andresarmento/Tinker-Trike/README.md

Tinker-Trike
============

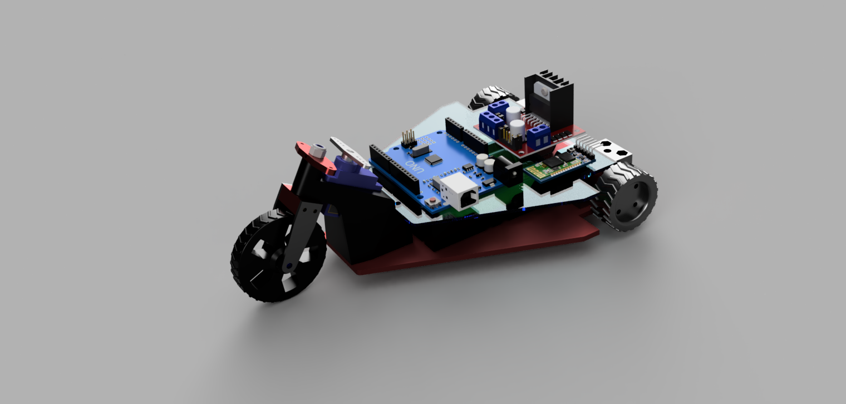
[picture p1: Trike_Complete_2025-Jul-01_01-31.png]
Trike V1.0
