andresarmento/Tinker-Trike/eletronica_trike.png

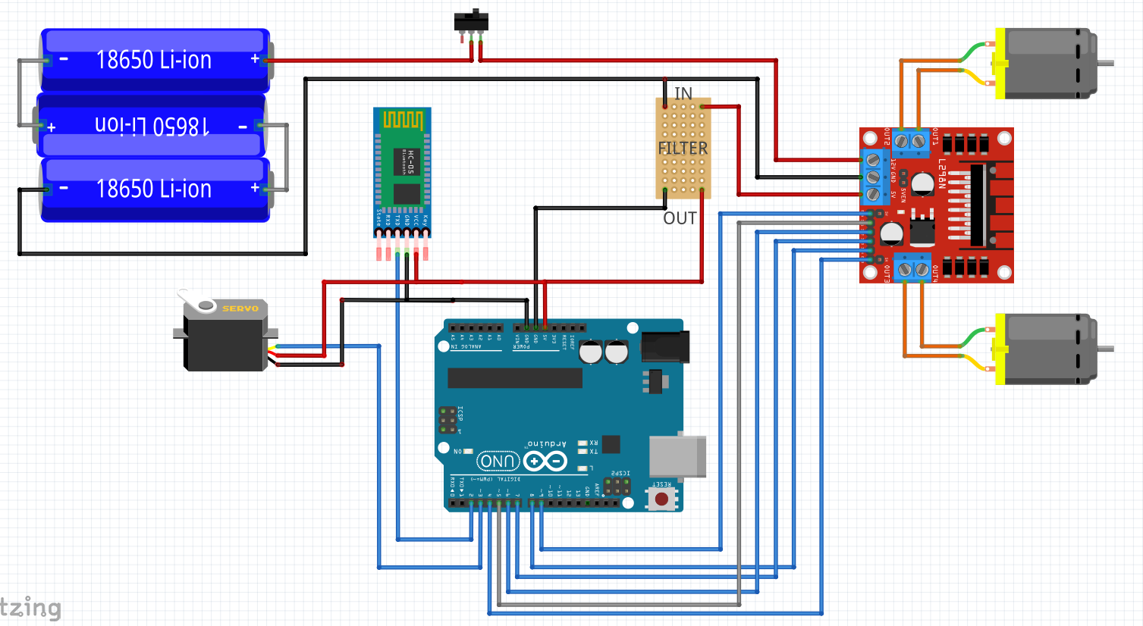
eletronica_trike.png
