andresarmento/Tinker-Trike/Parts models/3D prints/STL/Chassis v47.stl

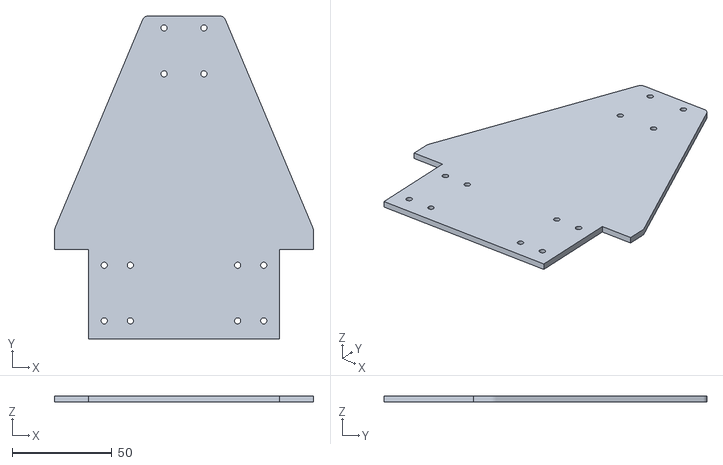
[picture p3: CAD file, 2026-05-27]
Parts models/3D prints/STL/Chassis v47.stl
130.0 x 162.0 x 3.00
