andresarmento/Tinker-Trike/Parts models/3D prints/STL/Top Plate v53.stl

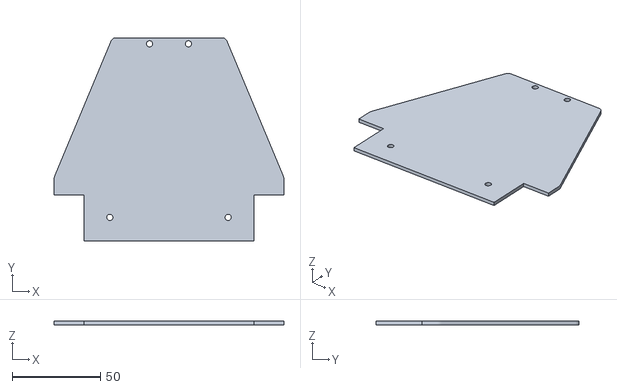
[picture p4: CAD file, 2026-05-27]
Parts models/3D prints/STL/Top Plate v53.stl
130.0 x 115.0 x 2.00
