andresarmento/Tinker-Trike/Parts models/3D prints/STL/Head Tube v43.stl

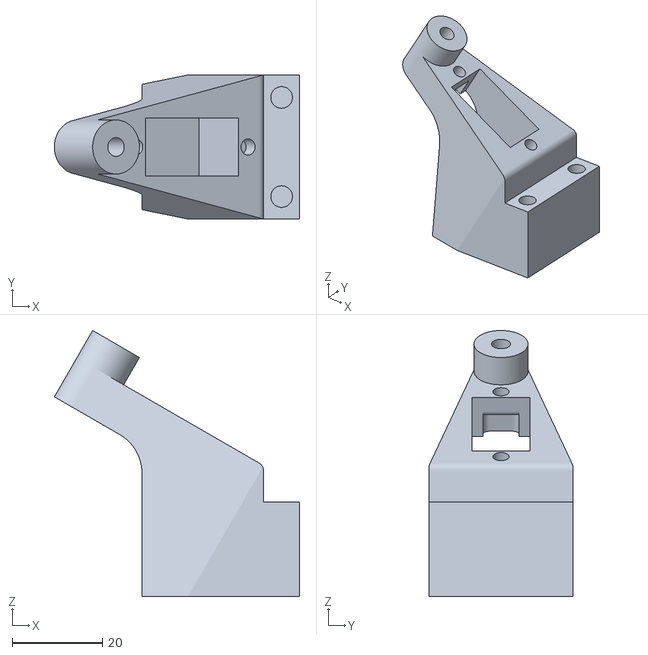
[picture p5: CAD file, 2025-07-05]
Parts models/3D prints/STL/Head Tube v43.stl
54.5 x 32.0 x 59.1
