andresarmento/Tinker-Trike/Parts models/3D prints/STL/Handlebar v12.stl

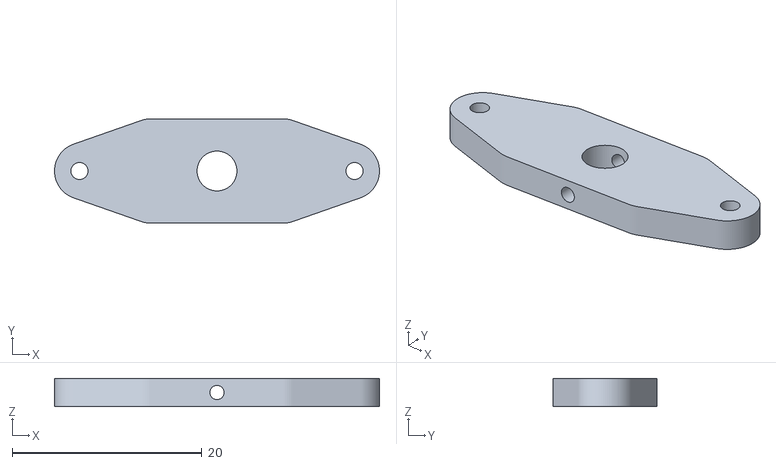
[picture p6: CAD file, 2025-07-05]
Parts models/3D prints/STL/Handlebar v12.stl
34.3 x 11.0 x 3.00
