andresarmento/Tinker-Trike/Parts models/3D prints/STL/Back Wheel No Tire v6.stl

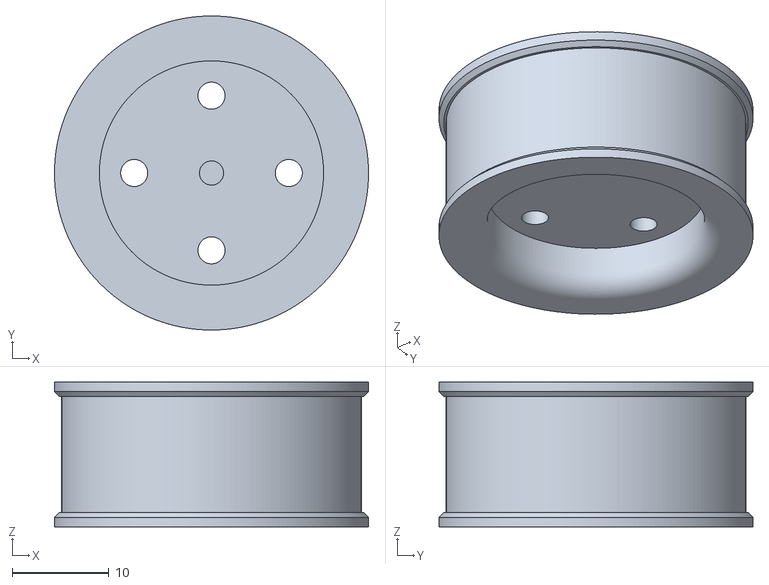
[picture p7: CAD file, 2025-07-05]
Parts models/3D prints/STL/Back Wheel No Tire v6.stl
32.5 x 32.5 x 15.0
