andresarmento/Tinker-Trike/Parts models/3D prints/STL/Servo Link v7.stl

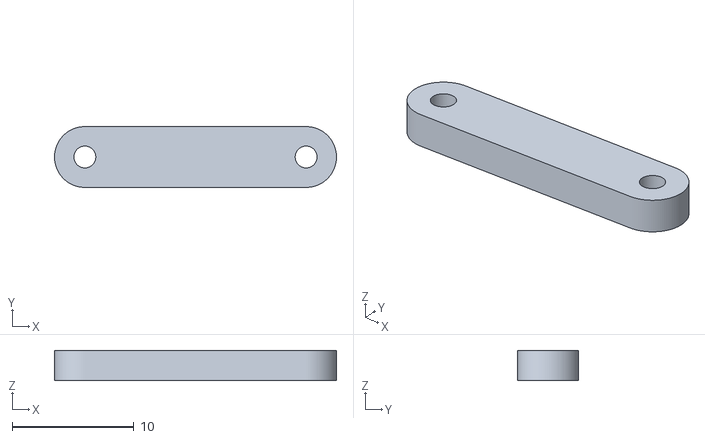
[picture p9: CAD file, 2025-07-05]
Parts models/3D prints/STL/Servo Link v7.stl
23.2 x 5.00 x 2.50
