andresarmento/Tinker-Trike/Parts models/3D prints/STL/Back Wheel v9.stl

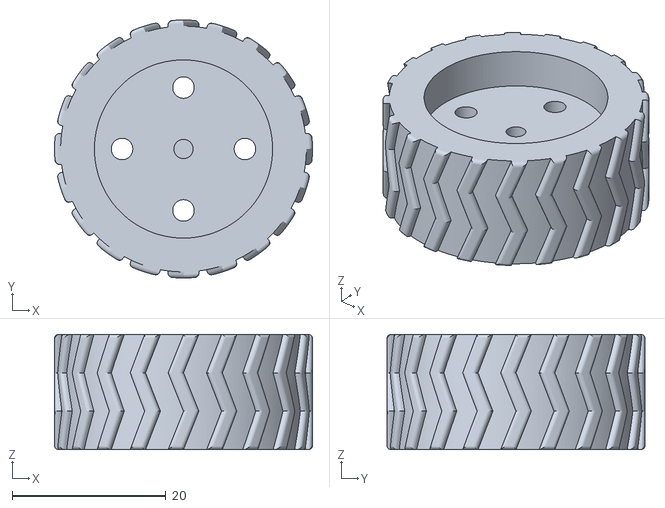
[picture p10: CAD file, 2025-07-05]
Parts models/3D prints/STL/Back Wheel v9.stl
33.6 x 33.6 x 15.0
