andresarmento/Tinker-Trike/Parts models/3D prints/STL/Flange 2.1mm v7.stl

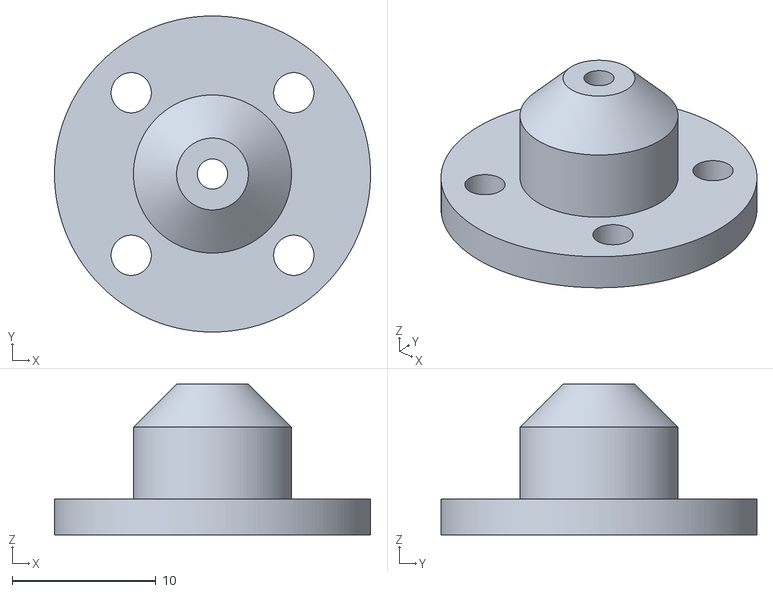
[picture p11: CAD file, 2025-07-05]
Parts models/3D prints/STL/Flange 2.1mm v7.stl
22.0 x 22.0 x 10.5
