andresarmento/Tinker-Trike/Parts models/3D prints/STL/Fork Base v22.stl

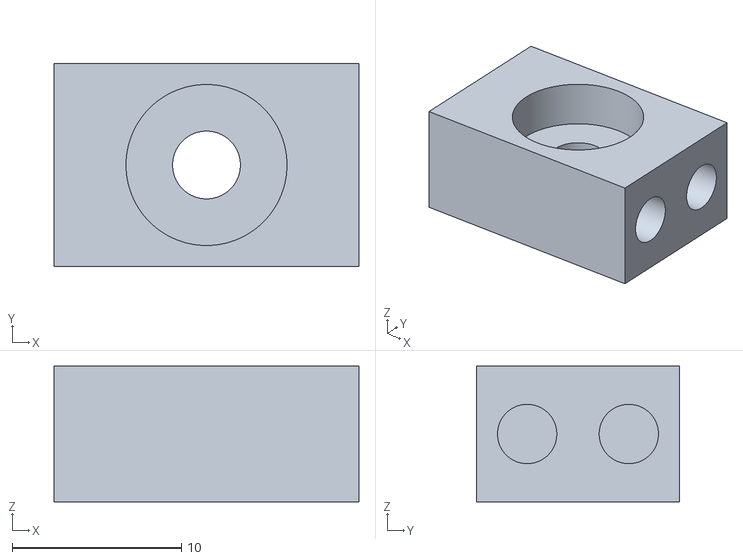
[picture p12: CAD file, 2025-07-05]
Parts models/3D prints/STL/Fork Base v22.stl
18.0 x 12.0 x 8.00
