andresarmento/Tinker-Trike/Parts models/3D prints/STL/Motor Box 180 v13.stl

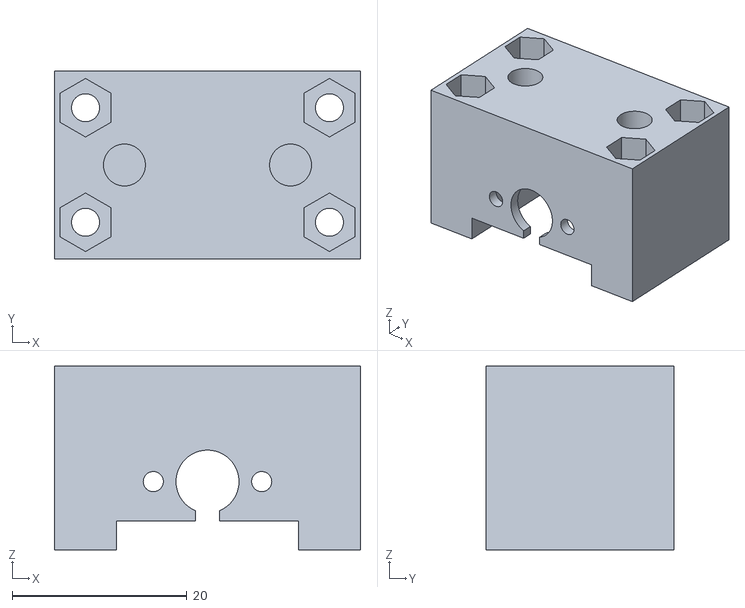
[picture p13: CAD file, 2025-07-05]
Parts models/3D prints/STL/Motor Box 180 v13.stl
35.0 x 21.5 x 21.0
