andresarmento/Tinker-Trike/Parts models/3D prints/STL/Front Wheel No Tire v3.stl

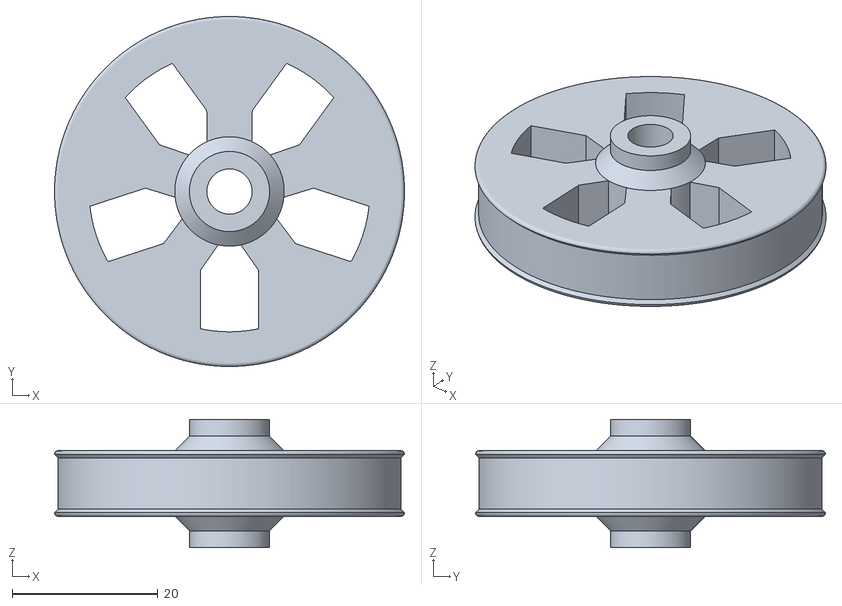
[picture p14: CAD file, 2025-07-01]
Parts models/3D prints/STL/Front Wheel No Tire v3.stl
48.0 x 48.0 x 17.6
