andresarmento/Tinker-Trike/Parts models/3D prints/STL/Front Wheel v20.stl

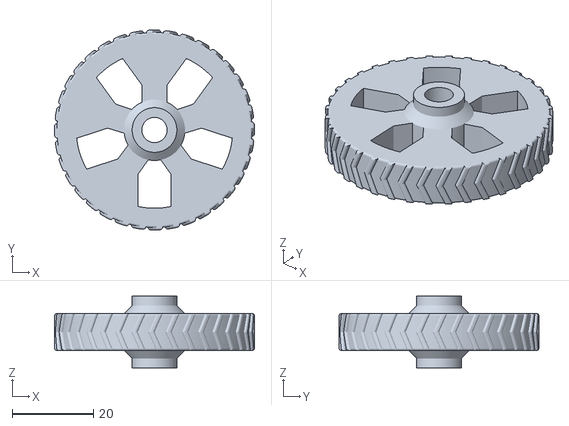
[picture p15: CAD file, 2025-07-01]
Parts models/3D prints/STL/Front Wheel v20.stl
49.2 x 49.2 x 17.6
