andresarmento/Tinker-Trike/Parts models/3D prints/STL/Front Wheel Axle v4.stl

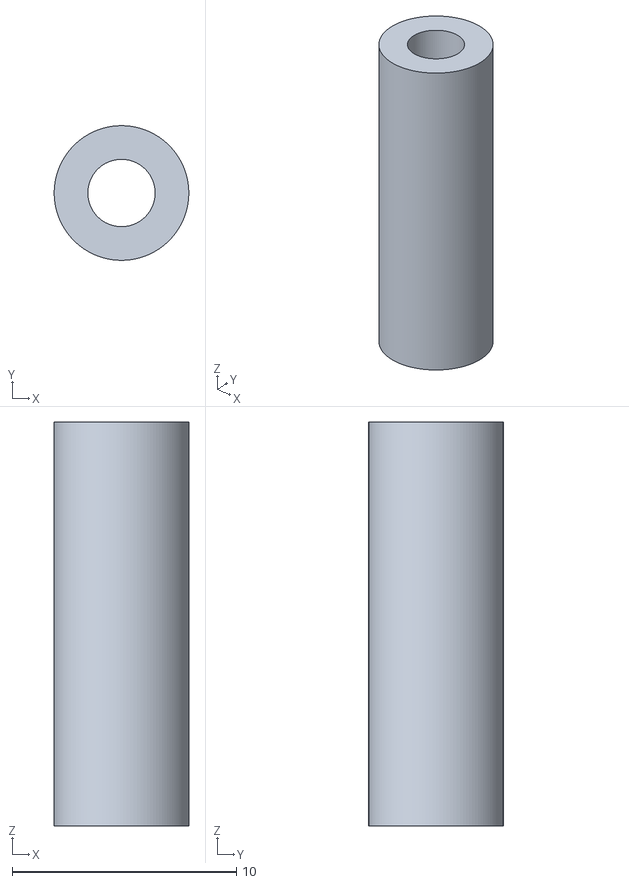
[picture p16: CAD file, 2025-07-01]
Parts models/3D prints/STL/Front Wheel Axle v4.stl
6.00 x 6.00 x 18.0
