andresarmento/Tinker-Trike/(list of files, cad)

Other CAD files:
Parts models/3D prints/STL/Flange 2.2mm v7.stl
Parts models/3D prints/STL/Flange 2.0mm v7.stl
Parts models/3D prints/STL/Flange 2.3mm v7.stl
Parts models/3D prints/Fusion/Back Wheel No Tire v6.f3d
Parts models/3D prints/Fusion/Back Wheel v9.f3d
Parts models/3D prints/Fusion/Flange 2mm v7.f3d
Parts models/3D prints/Fusion/Fork Base v22.f3d
Parts models/3D prints/Fusion/Front Wheel Axle v4.f3d
Parts models/3D prints/Fusion/Front Wheel No Tire v3.f3d
Parts models/3D prints/Fusion/Front Wheel v20.f3d
Parts models/3D prints/Fusion/Handlebar v12.f3d
Parts models/3D prints/Fusion/Head Tube Bearings v3.f3d
Parts models/3D prints/Fusion/Head Tube v43.f3d
Parts models/3D prints/Fusion/Motor Box 180 v13.f3d
Parts models/3D prints/Fusion/Servo Link v7.f3d
Parts models/CNC cuts/Fusion/Chassis v45.f3d
Parts models/CNC cuts/Fusion/Fork End v21.f3d
Parts models/CNC cuts/Fusion/Top Plate v50.f3d
Parts models/Electronics/3x18650 Battery Holder v3.f3d
Parts models/Electronics/Arduino UNO v4.f3d
Parts models/Electronics/H-Bridge_L298N v1.f3d
Parts models/Electronics/HC05_Modulo v2.f3d
Parts models/Electronics/Motor-FK-180 SH v1.f3d
Parts models/Electronics/Servo Arm v8.f3d
Parts models/Electronics/Servo SG90 v1.f3d
Parts models/Nuts and Bolts/Hex Nut M4 v2.f3d
Parts models/Nuts and Bolts/Insert M2 L4 v1.f3d
Parts models/Nuts and Bolts/Insert M3 L5 v2.f3d
Parts models/Nuts and Bolts/Lock Nut M4 v1.f3d
Parts models/Nuts and Bolts/M3x25 v3.f3d
Parts models/Nuts and Bolts/M3x8 v2.f3d
Parts models/Nuts and Bolts/Screw M4 x 30 v6.f3d
Parts models/Nuts and Bolts/Spacer v4.f3d
