andresarmento/Tinker-Trike/(list of files, drawings)

Other design files:
Trike.fzz
