andresarmento/Tinker-Trike/(commit log)

2025-07-01 3d files upload
    [3x18650 Battery Holder v3.f3d, Arduino UNO v4.f3d, Back Wheel Tire v3.f3d, Back Wheel Tire v3.stl, Back Wheel v5.f3d, Back Wheel v5.stl, Chassis v45.f3d, Flange 2mm v2.f3d]
2025-07-01 Nuts, bolts and minor corrections
    [Back Wheel Tire v3.f3d, Back Wheel Tire v3.stl, Back Wheel Without Tire v3.f3d, Back Wheel Without Tire v3.stl, Back Wheel v5.f3d, Back Wheel v5.stl, Back Wheel v6.f3d, Back Wheel v6.stl]
2025-07-03 Wheel corrections
    [Back Wheel No Tire v4.f3d, Back Wheel No Tire v4.stl, Back Wheel Without Tire v3.f3d, Back Wheel Without Tire v3.stl, Back Wheel v6.f3d, Back Wheel v6.stl, Back Wheel v7.f3d, Back Wheel v7.stl]
2025-07-03 Manual (draft) and servo link first versions
    [Servo Link v6.f3d, Servo Link v6.stl]
2025-07-05 small models corrections
    [Back Wheel No Tire v4.f3d, Back Wheel No Tire v4.stl, Back Wheel No Tire v6.f3d, Back Wheel No Tire v6.stl, Back Wheel v7.f3d, Back Wheel v7.stl, Back Wheel v9.f3d, Back Wheel v9.stl]
2025-08-18 Eletronica do trike
    [Trike.fzz]
2026-05-27 STLs for chassis and top plate
    [Chassis v47.stl, Top Plate v53.stl]
